russellmcc/lv-amp/lv_amp.kicad_pcb

## KiCad design lv_amp.kicad_pcb (2025-04-13)

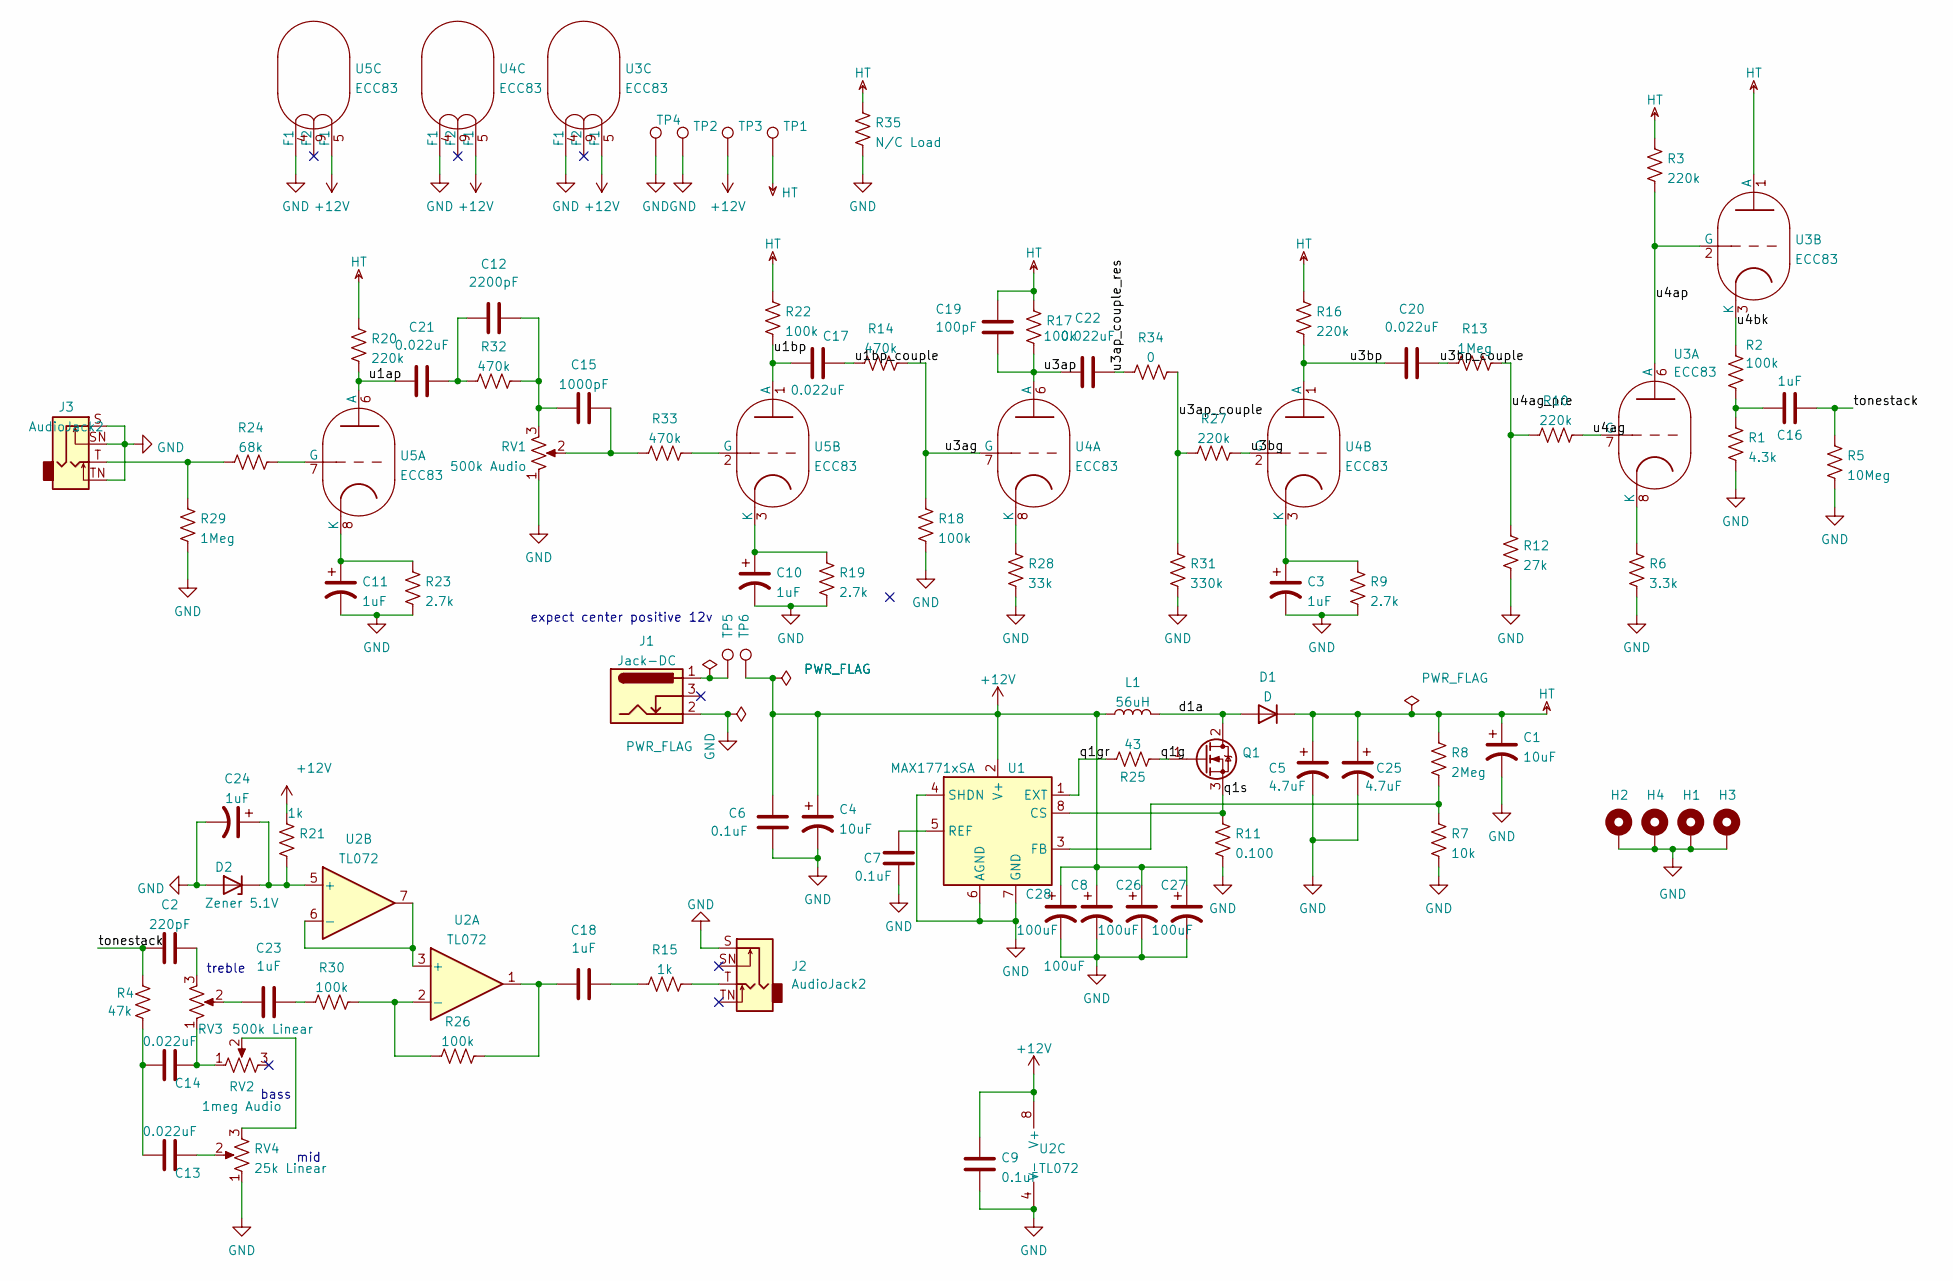
[picture p1: schematic lv_amp.kicad_sch]

Parts:
C1: 10uF; CP_Elec_16x17.5
C2: 220pF; C_0603_1608Metric
C3, C10, C11, C24: 1uF; CP_Elec_4x5.4
C4: 10uF; CP_EIA-6032-28_Kemet-C
C5, C25: 4.7uF; CP_Elec_10x10
C6, C7, C9: 0.1uF; C_0805_2012Metric
C8, C26, C27, C28: 100uF; CP_EIA-7343-43_Kemet-X
C12: 2200pF; C_0805_2012Metric
C13, C14: 0.022uF; C_0805_2012Metric
C15: 1000pF; C_0805_2012Metric
C16, C18, C23: 1uF; C_Rect_L18.0mm_W7.0mm_P15.00mm_FKS3_FKP3
C17, C20, C21, C22: 0.022uF; C_Rect_L13.0mm_W4.0mm_P10.00mm_FKS3_FKP3_MKS4
C19: 100pF; C_Rect_L18.0mm_W5.0mm_P15.00mm_FKS3_FKP3
D1: D; TO-263-2_TabPin1
D2: Zener 5.1V; D_SOT-23_ANK
H1, H2, H3, H4: MountingHole_Pad; MountingHole_3.2mm_M3
J1: Jack-DC; Kobiconn 179PH
J2, J3: AudioJack2; Jack_6.35mm_Neutrik_NRJ4HF_Horizontal
L1: 56uH; pm2110
Q1: Q_NMOS_DGS; TO-263-2
R1: 4.3k; R_0603_1608Metric
R2, R17, R22: 100k; R_2512_6332Metric
R3, R10, R16, R20, R27: 220k; R_1210_3225Metric
R4: 47k; R_0603_1608Metric
R5: 10Meg; R_0603_1608Metric
R6: 3.3k; R_1206_3216Metric
R7: 10k; R_0603_1608Metric
R8: 2Meg; R_2512_6332Metric
R9, R19, R23: 2.7k; R_1206_3216Metric
R11: 0.100; R_2512_6332Metric
R12: 27k; R_2512_6332Metric
R13, R29: 1Meg; R_0603_1608Metric
R14, R32, R33: 470k; R_1206_3216Metric
R15, R21: 1k; R_0603_1608Metric
R18, R26, R30: 100k; R_0603_1608Metric
R24: 68k; R_0603_1608Metric
R25: 43; R_0603_1608Metric
R28: 33k; R_0805_2012Metric
R31: 330k; R_1210_3225Metric
R34: 0; R_1210_3225Metric
R35: N/C Load; R_Axial_DIN0309_L9.0mm_D3.2mm_P15.24mm_Horizontal
RV1: 500k Audio; Potentiometer_Piher_T-16H_Single_Horizontal
RV2: 1meg Audio; Potentiometer_Piher_T-16H_Single_Horizontal
RV3: 500k Linear; Potentiometer_Piher_T-16H_Single_Horizontal
RV4: 25k Linear; Potentiometer_Piher_T-16H_Single_Horizontal
TP1, TP2, TP3, TP4, TP5, TP6: TestPoint; TestPoint_THTPad_2.0x2.0mm_Drill1.0mm
U1: MAX1771xSA; SO-8_3.9x4.9mm_P1.27mm
U2: TL072; SO-8_3.9x4.9mm_P1.27mm
U3, U4, U5: ECC83; 12ax7

Connections:
+12V: C4.1, C6.1, C8.1, C9.1, C26.1, C27.1, C28.1, L1.1, R21.1, TP3.1, TP6.1, U1.2 (V+), U2.8 (V+), U3.5 (F1), U4.5 (F1), U5.5 (F1)
/d1a: D1.2 (A), L1.2, Q1.2 (D)
/q1g: Q1.1 (G), R25.2
/q1gr: R25.1, U1.1 (EXT)
/q1s: Q1.3 (S), R11.1, U1.8 (CS)
/tonestack: C2.1, C16.2, R4.2, R5.2
/u1ap: C21.1, R20.2, U5.6 (A)
/u1bp: C17.1, R22.2, U5.1 (A)
/u1bp_couple: C17.2, R14.1
/u3ag: R14.2, R18.2, U4.7 (G)
/u3ap: C19.2, C22.1, R17.2, U4.6 (A)
/u3ap_couple: R27.1, R31.2, R34.1
/u3ap_couple_res: C22.2, R34.2
/u3bg: R27.2, U4.2 (G)
/u3bp: C20.1, R16.2, U4.1 (A)
/u3bp_couple: C20.2, R13.1
/u4ag: R10.2, U3.7 (G)
/u4ag_pre: R10.1, R12.2, R13.2
/u4ap: R3.2, U3.2 (G), U3.6 (A)
/u4bk: R2.1, U3.3 (K)
GND: C1.2, C3.2, C4.2, C5.2, C6.2, C7.2, C8.2, C9.2, C10.2, C11.2, C24.2, C25.2, C26.2, C27.2, C28.2, D2.2 (A), H1.1, H2.1, H3.1, H4.1, J1.2, J2.S, J3.S, J3.SN, J3.TN, R1.2, R5.1, R6.2, R7.2, R9.2, R11.2, R12.1, R18.1, R19.2, R23.2, R28.1, R29.2, R31.1, R35.2, RV1.1, RV4.1, TP2.1, TP4.1, U1.4 (SHDN), U1.6 (AGND), U1.7 (GND), U2.4 (V-), U3.4 (F1), U4.4 (F1), U5.4 (F1)
HT: C1.1, C5.1, C19.1, C25.1, D1.1 (K), R3.1, R8.1, R16.1, R17.1, R20.1, R22.1, R35.1, TP1.1, U3.1 (A)
unnamed: C2.2, RV3.3
unnamed: C12.1, C21.2, R32.1
unnamed: C12.2, C15.1, R32.2, RV1.3
unnamed: C13.1, C14.1, R4.1
unnamed: C13.2, RV4.2
unnamed: C14.2, RV2.1, RV3.1
unnamed: C15.2, R33.1, RV1.2
unnamed: C16.1, R1.1, R2.2
unnamed: C18.1, R26.1, U2.1
unnamed: C18.2, R15.2
unnamed: C23.1, RV3.2
unnamed: C23.2, R30.2
unnamed: C24.1, D2.1 (K), R21.2, U2.5 (+)
unnamed: J1.1, TP5.1
unnamed: J2.T, R15.1
unnamed: J3.T, R24.2, R29.1
unnamed: RV2.2, RV4.3
unnamed: R7.1, R8.2, U1.3 (FB)
unnamed: C7.1, U1.5 (REF)
unnamed: U2.3 (+), U2.6 (-), U2.7
unnamed: R26.2, R30.1, U2.2 (-)
unnamed: R6.1, U3.8 (K)
unnamed: R28.2, U4.8 (K)
unnamed: C3.1, R9.1, U4.3 (K)
unnamed: R24.1, U5.7 (G)
unnamed: C11.1, R23.1, U5.8 (K)
unnamed: R33.2, U5.2 (G)
unnamed: C10.1, R19.1, U5.3 (K)

Notes on the sheet:
treble
expect center positive 12v
mid
bass

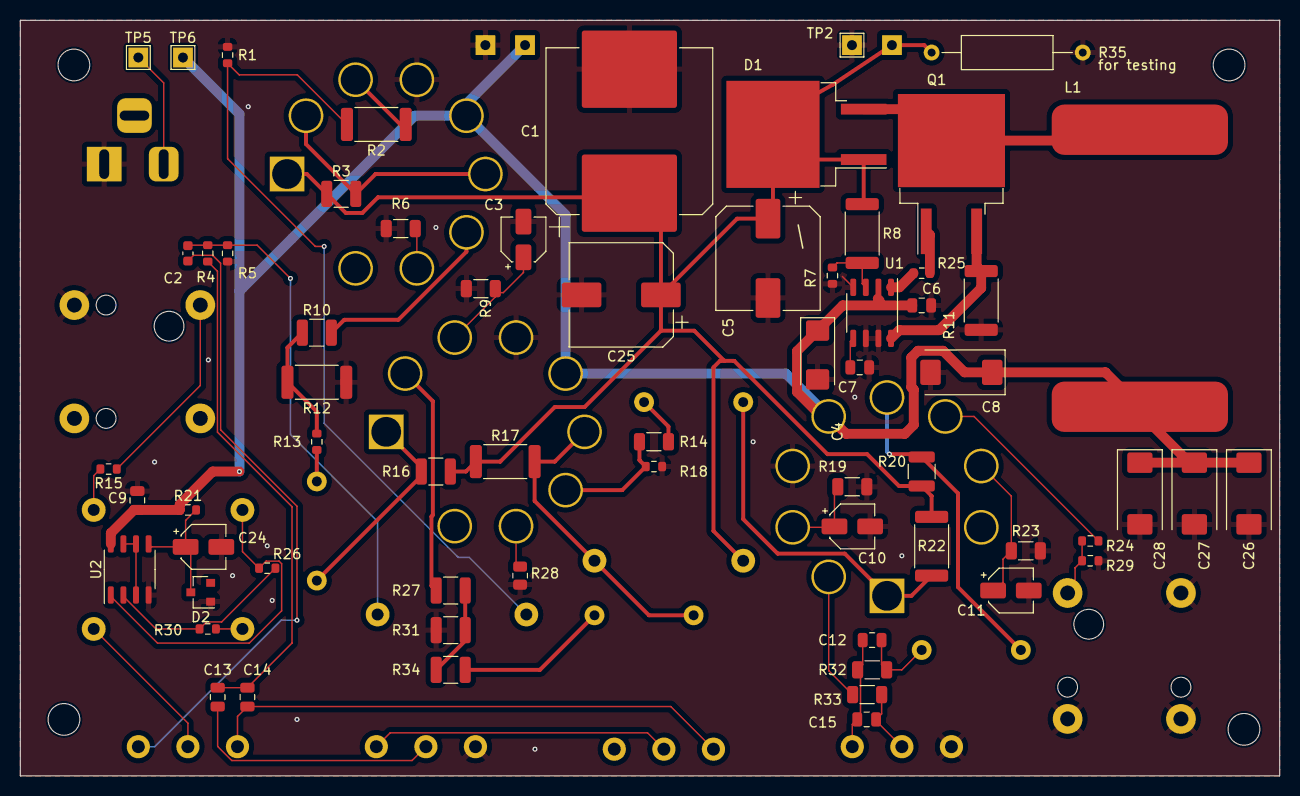
[picture p2: board lv_amp.kicad_pcb from above]

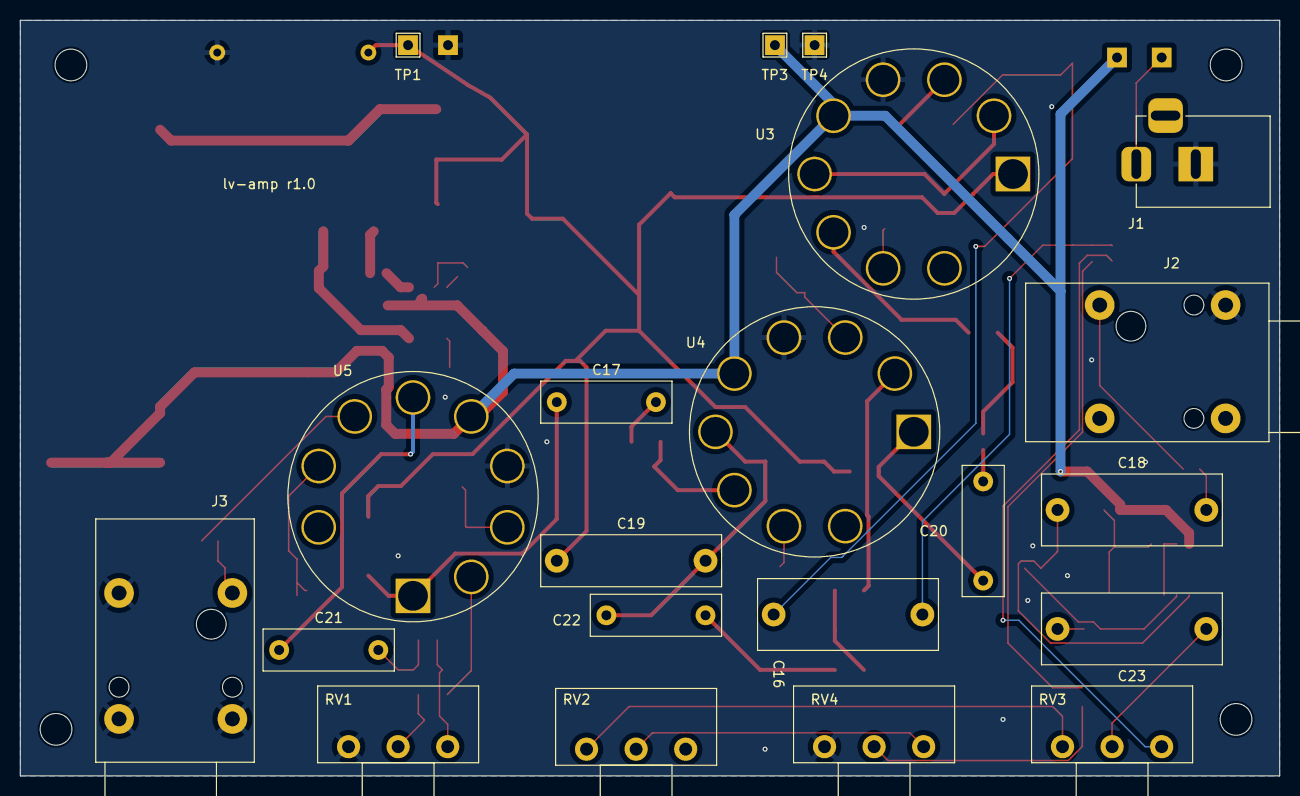
[picture p3: board lv_amp.kicad_pcb from below]

Board: 2 copper layers, 127.0 x 76.2 mm, 89 parts (21 on the bottom side), 50 nets.
