russellmcc/lv-amp/(commit log)

2022-02-21 power supply parts
    [lv_amp.kicad_sch]
2022-02-21 update footprints
    [lv_amp.kicad_sch]
2022-02-21 add net classes
    [lv_amp.kicad_sch]
2022-02-21 power supply layout
    [lv_amp.kicad_pcb, lv_amp.kicad_sch]
2022-02-21 initial layout
    [lv_amp.kicad_pcb]
2022-02-21 tighter layout
    [lv_amp.kicad_pcb, lv_amp.kicad_sch]
2022-02-21 alpha0 errata: DC jack
    [lv_amp.kicad_pcb, lv_amp.kicad_sch]
2022-02-21 alpha0 errata: dd zener diode to output reference
    [lv_amp.kicad_pcb, lv_amp.kicad_sch]
2022-02-21 alpha0 errata: better output filtering on supply
    [lv_amp.kicad_pcb, lv_amp.kicad_sch]
2022-02-21 alpha0 errata: more input filtering on inductor
    [lv_amp.kicad_pcb, lv_amp.kicad_sch]
2022-02-21 alpha0 errata: add gate resistor for switching mosfet
    [lv_amp.kicad_pcb, lv_amp.kicad_sch]
2022-02-21 alpha0 errata: note taper for pots
    [lv_amp.kicad_sch]
2022-02-21 alpha0 errata: flip mid pot
    [lv_amp.kicad_pcb, lv_amp.kicad_sch]
2022-02-21 alpha0 errata: reduce R18 to reduce stage 4 gain
    [lv_amp.kicad_pcb, lv_amp.kicad_sch]
2022-02-21 alpha0 errata: increase r1 to 4.3k to increase output level
    [lv_amp.kicad_pcb, lv_amp.kicad_sch]
2022-02-21 alpha0 errata: decrease r12 to 27k to reduce stage 5 gain
    [lv_amp.kicad_pcb, lv_amp.kicad_sch]
2022-02-21 alpha0 errata: add 0ohm resistor for easier modding of stage 4
    [lv_amp.kicad_pcb, lv_amp.kicad_sch]
2022-02-21 alpha0 errata: add slot for load resistor for testing
    [lv_amp.kicad_pcb, lv_amp.kicad_sch]
2022-02-21 alpha1 complete
    [lv_amp.kicad_pcb]
2022-02-21 shuffle stuff around to minimize antenna length
    [lv_amp.kicad_pcb]
2022-02-21 5v zener
    [lv_amp.kicad_pcb, lv_amp.kicad_sch]
2022-02-21 use 5.1 zener
    [lv_amp.kicad_pcb, lv_amp.kicad_sch]
2022-02-21 Fix vendor links
    [lv_amp.kicad_sch]
2022-02-27 Oops un-flip mid pot
    [lv_amp.kicad_pcb, lv_amp.kicad_sch]
2022-02-27 Errata: flip pot order
    [lv_amp.kicad_pcb]
2025-04-13 errata - add power switch
    [lv_amp.kicad_pcb, lv_amp.kicad_sch]
2025-04-13 power switch on hot side; fix drc fails in new version
    [lv_amp.kicad_pcb, lv_amp.kicad_sch]
